nledevil/Racer/hardware/racer/racer.kicad_sch

## KiCad design hardware/racer/racer.kicad_sch (2024-10-18)

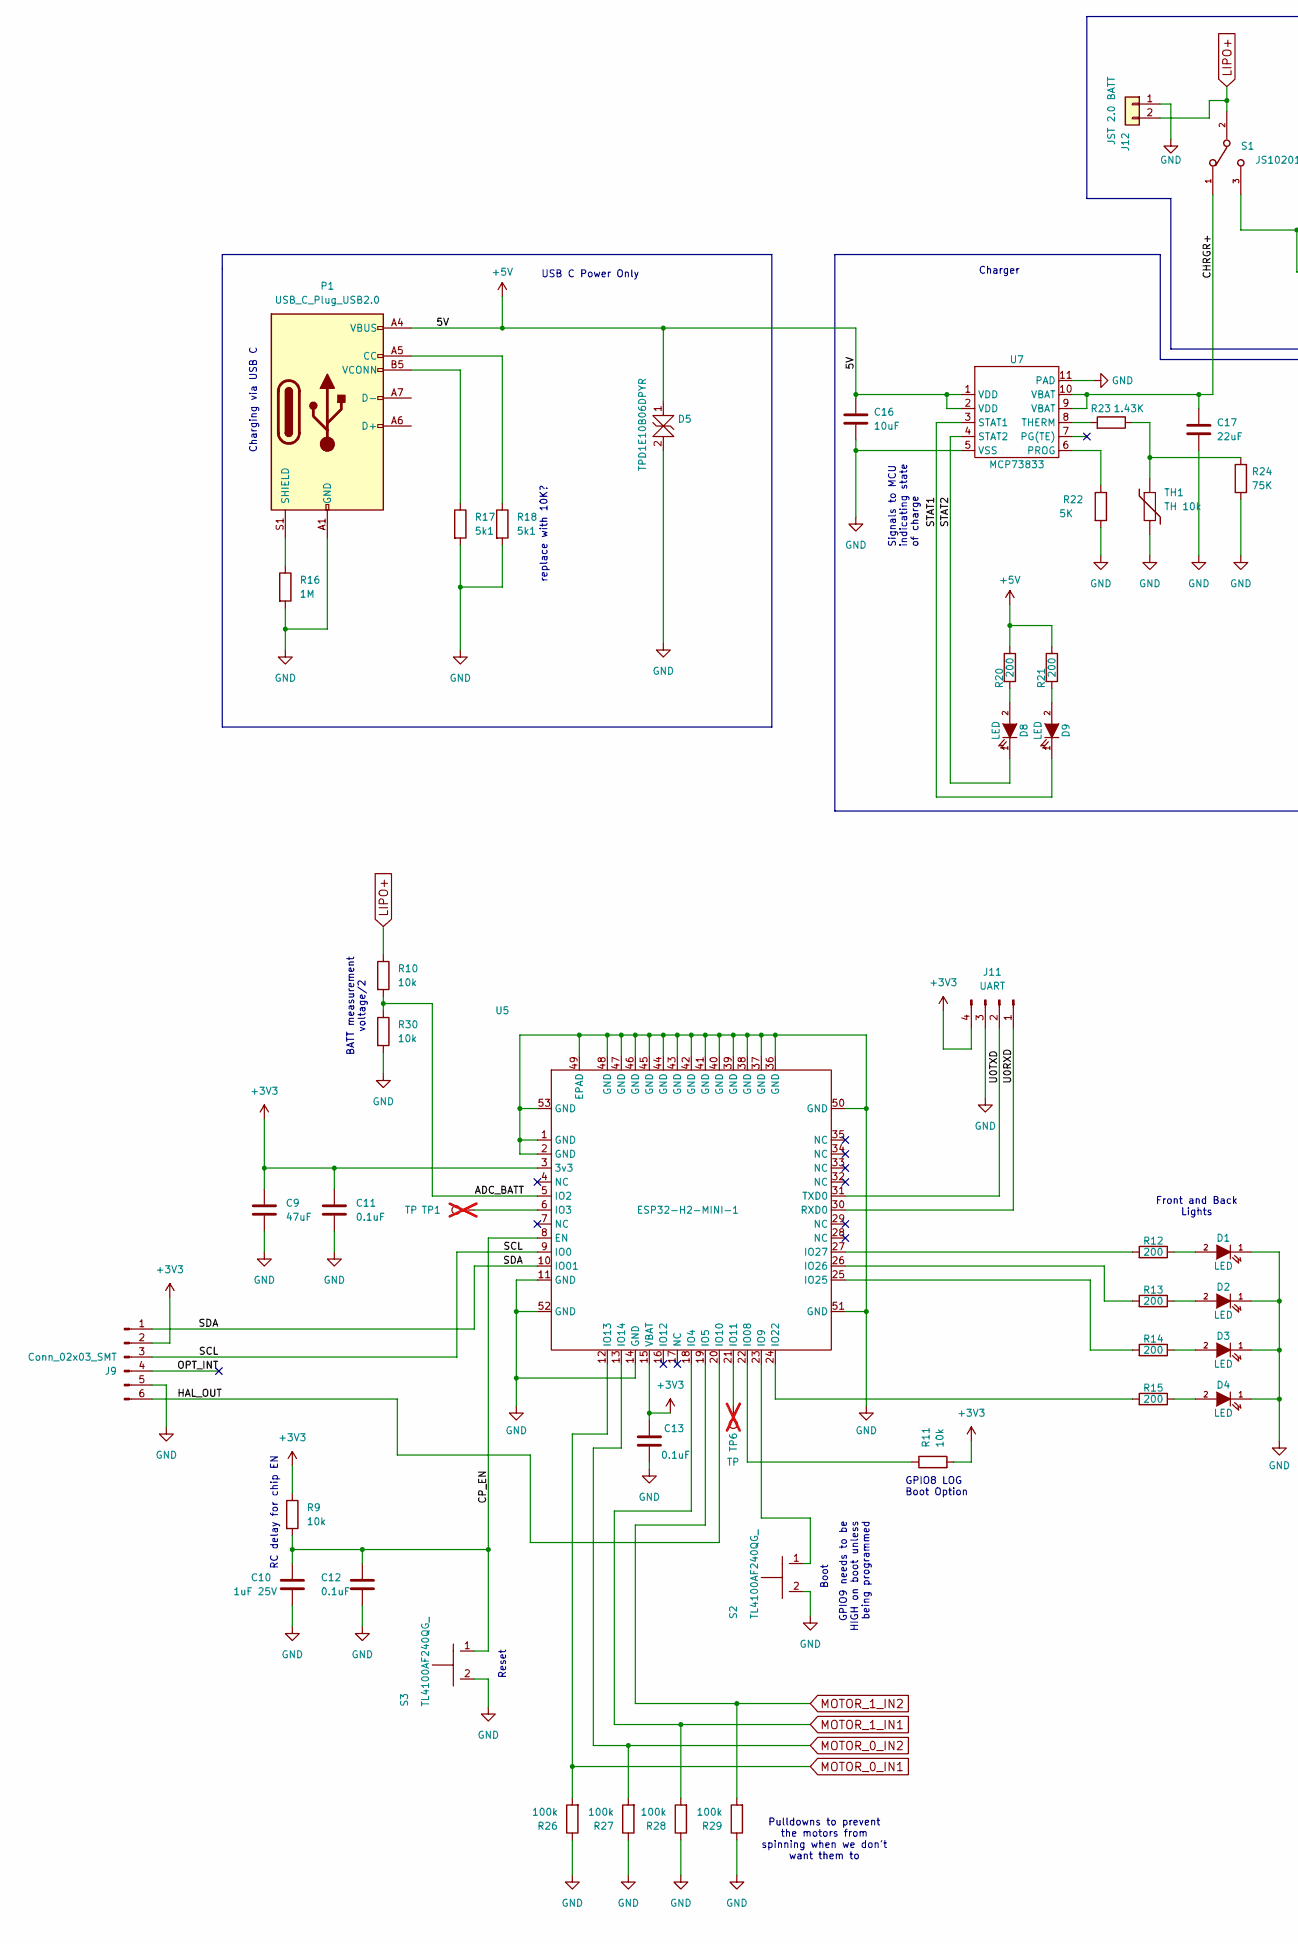
[picture p1: schematic racer.kicad_sch, part in row 1, column 1]

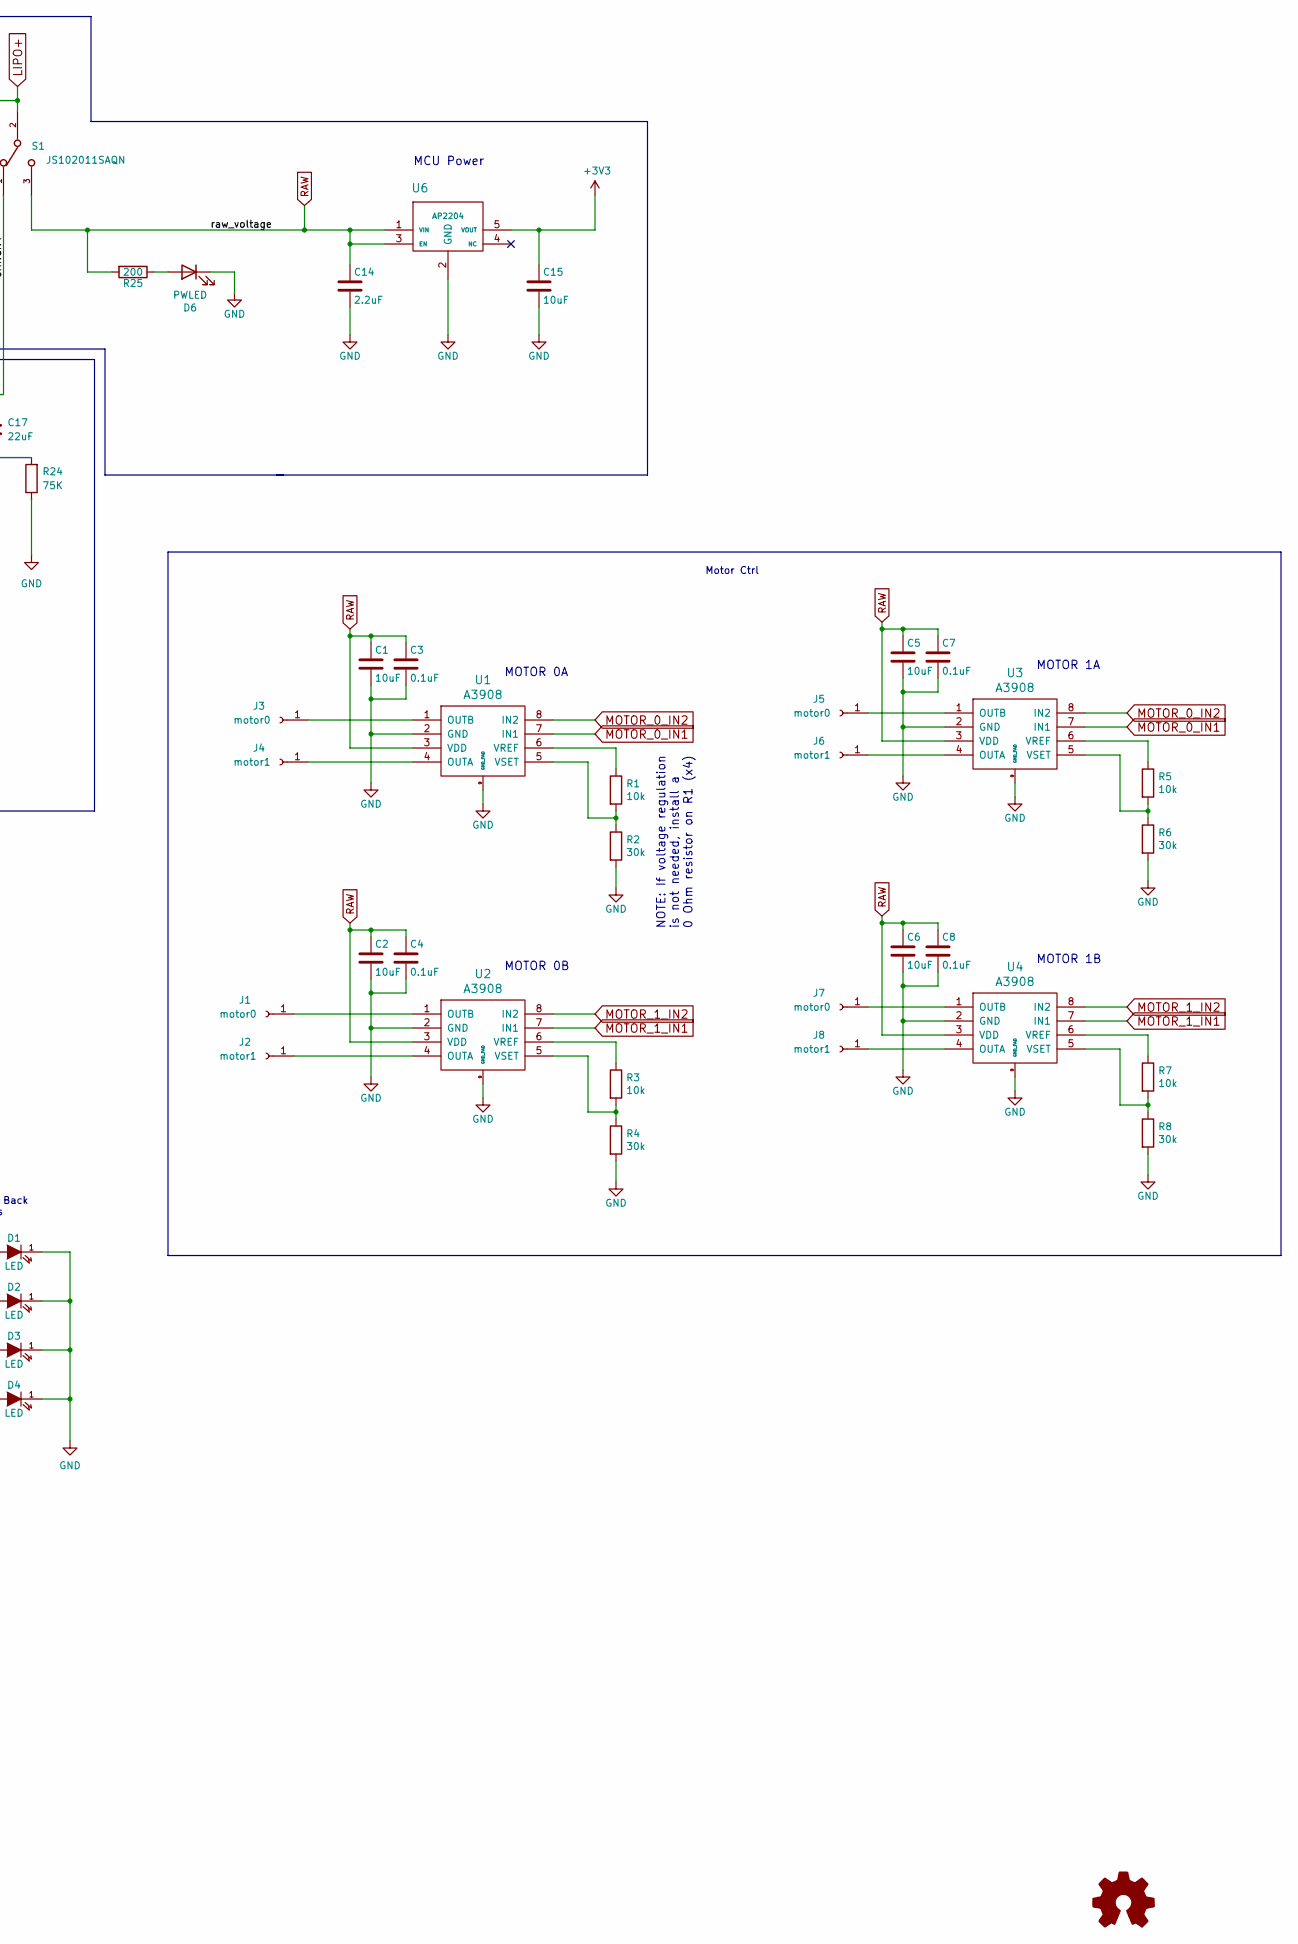
[picture p2: schematic racer.kicad_sch, part in row 1, column 2]

Parts:
C1, C2, C5, C6, C15, C16: 10uF; C_0603_1608Metric; LCSC C19702
C3, C4, C7, C8, C11, C12, C13: 0.1uF; C_0603_1608Metric; LCSC C14663
C9: 47uF; C_0603_1608Metric; LCSC C178330
C10: 1uF 25V; C_0603_1608Metric; LCSC C15849
C14: 2.2uF; C_0603_1608Metric; LCSC C23630
C17: 22uF; C_0603_1608Metric; LCSC C59461
D1, D2, D8, D9: LED; C_0603_1608Metric; LCSC C2286
D3, D4: LED; C_0603_1608Metric; LCSC C2290
D5: TPD1E10B06DPYR; D_SOD-523; LCSC C314264
D6: PWLED; D_0603_1608Metric; LCSC C2286
J1, J3, J5, J7: motor0; TestPoint_Pad_2.0x2.0mm
J2, J4, J6, J8: motor1; TestPoint_Pad_2.0x2.0mm
J9: Conn_02x03_SMT; PinHeader_2x03_P1.27mm_Vertical_SMD
J11: UART; PinHeader_1x04_P2.54mm_Vertical; LCSC C7430360
J12: JST 2.0 BATT; JST_PH_B2B-PH-K_1x02_P2.00mm_Vertical; LCSC C594142
P1: USB_C_Plug_USB2.0; CUI_UJC-VP-3-SMT-TR
R1, R3, R5, R7, R9, R10, R11, R30: 10k; R_0603_1608Metric; LCSC C25804
R2, R4, R6, R8: 30k; R_0603_1608Metric; LCSC C22984
R12, R13, R14, R15, R20, R21, R25: 200; R_0603_1608Metric; LCSC C8218
R16: 1M; R_0603_1608Metric; LCSC C22935
R17, R18: 5k1; R_0603_1608Metric; LCSC C23186
R22: 5K; R_0603_1608Metric
R23: 1.43K; R_0603_1608Metric
R24: 75K; R_0603_1608Metric; LCSC C23242
R26, R27, R28, R29: 100k; R_0603_1608Metric; LCSC C25803
S1: JS102011SAQN; SW_JS102011SAQN
S2, S3: TL4100AF240QG_; SW_PTS810_SJM_250_SMTR_LFS; LCSC C455282
TH1: TH 10k; R_0603_1608Metric; LCSC C13564
TP1, TP6: TP; TestPoint_Pad_D1.0mm; not fitted
U1, U2, U3, U4: A3908
U5: ESP32-H2-MINI-1; MODULE_ESP32-H2-MINI-1-H2; LCSC C18202993
U6: AP2204; LCSC C20627184
U7: MCP73833; SON50P300X300X100-11N; LCSC C627668

Connections:
+3V3: C9.1, C11.1, C13.1, C15.1, J9.2, J11.4, R9.1, R11.2, U5.3 (3v3), U5.15 (VBAT), U6.5 (VOUT)
+5V: C16.1, D5.1, P1.A4 (VBUS), P1.A9 (VBUS), P1.B4 (VBUS), P1.B9 (VBUS), R20.1, R21.1, U7.1 (VDD), U7.2 (VDD)
ADC_BATT: R10.2, R30.1, U5.5 (IO2)
CHRGR+: C17.1, S1.1, U7.9 (VBAT), U7.10 (VBAT)
CP_EN: C10.1, C12.1, R9.2, S3.1, U5.8 (EN)
GND: C1.2, C2.2, C3.2, C4.2, C5.2, C6.2, C7.2, C8.2, C9.2, C10.2, C11.2, C12.2, C13.2, C14.2, C15.2, C16.2, C17.2, D1.1 (K), D2.1 (K), D3.1 (K), D4.1 (K), D5.2, D6.1 (K), J9.5, J11.3, J12.1, P1.A1 (GND), P1.A12 (GND), P1.B1 (GND), P1.B12 (GND), R2.2, R4.2, R6.2, R8.2, R16.2, R17.2, R18.2, R22.2, R24.1, R26.1, R27.1, R28.1, R29.1, R30.2, S2.2, S3.2, TH1.2, U1.2 (GND), U1.9 (GND_PAD), U2.2 (GND), U2.9 (GND_PAD), U3.2 (GND), U3.9 (GND_PAD), U4.2 (GND), U4.9 (GND_PAD), U5.1 (GND), U5.2 (GND), U5.11 (GND), U5.14 (GND), U5.36 (GND), U5.37 (GND), U5.38 (GND), U5.39 (GND), U5.40 (GND), U5.41 (GND), U5.42 (GND), U5.43 (GND), U5.44 (GND), U5.45 (GND), U5.46 (GND), U5.47 (GND), U5.48 (GND), U5.49 (EPAD), U5.50 (GND), U5.51 (GND), U5.52 (GND), U5.53 (GND), U6.2 (GND), U7.5 (VSS), U7.11 (PAD)
HAL_OUT: J9.6, U5.20 (IO10)
LIPO+: J12.2, R10.1, S1.2
MOTOR_0_IN1: R26.2, U1.7 (IN1), U3.7 (IN1), U5.12 (IO13)
MOTOR_0_IN2: R27.2, U1.8 (IN2), U3.8 (IN2), U5.13 (IO14)
MOTOR_1_IN1: R28.2, U2.7 (IN1), U4.7 (IN1), U5.18 (IO4)
MOTOR_1_IN2: R29.2, U2.8 (IN2), U4.8 (IN2), U5.19 (IO5)
unnamed: D1.2 (A), R12.1
unnamed: D2.2 (A), R13.1
unnamed: D3.2 (A), R14.1
unnamed: D4.2 (A), R15.1
unnamed: D6.2 (A), R25.1
unnamed: D8.2 (A), R20.2
unnamed: D9.2 (A), R21.2
unnamed: J1.1, U2.1 (OUTB)
unnamed: J2.1, U2.4 (OUTA)
unnamed: J3.1, U1.1 (OUTB)
unnamed: J4.1, U1.4 (OUTA)
unnamed: J5.1, U3.1 (OUTB)
unnamed: J6.1, U3.4 (OUTA)
unnamed: J7.1, U4.1 (OUTB)
unnamed: J8.1, U4.4 (OUTA)
unnamed: P1.A5 (CC), R18.1
unnamed: P1.B5 (VCONN), R17.1
unnamed: P1.S1 (SHIELD), R16.1
unnamed: R1.1, U1.6 (VREF)
unnamed: R1.2, R2.1, U1.5 (VSET)
unnamed: R3.1, U2.6 (VREF)
unnamed: R3.2, R4.1, U2.5 (VSET)
unnamed: R5.1, U3.6 (VREF)
unnamed: R5.2, R6.1, U3.5 (VSET)
unnamed: R7.1, U4.6 (VREF)
unnamed: R7.2, R8.1, U4.5 (VSET)
unnamed: R11.1, U5.22 (IO08)
unnamed: R12.2, U5.27 (IO27)
unnamed: R13.2, U5.26 (IO26)
unnamed: R14.2, U5.25 (IO25)
unnamed: R15.2, U5.24 (IO22)
unnamed: R22.1, U7.6 (PROG)
unnamed: R23.1, R24.2, TH1.1
unnamed: R23.2, U7.8 (THERM)
unnamed: S2.1, U5.23 (IO9)
unnamed: TP1.1, U5.6 (IO3)
unnamed: TP6.1, U5.21 (IO11)
OPT_INT: J9.4
RAW: C1.1, C2.1, C3.1, C4.1, C5.1, C6.1, C7.1, C8.1, C14.1, R25.2, S1.3, U1.3 (VDD), U2.3 (VDD), U3.3 (VDD), U4.3 (VDD), U6.1 (VIN), U6.3 (EN)
SCL: J9.3, U5.9 (IO0)
SDA: J9.1, U5.10 (IO01)
STAT1: D9.1 (K), U7.3 (STAT1)
STAT2: D8.1 (K), U7.4 (STAT2)
U0RXD: J11.1, U5.30 (RXD0)
U0TXD: J11.2, U5.31 (TXD0)

Notes on the sheet:
MOTOR 1B
Charging via USB C
Signals to MCU indicating state of charge
RC delay for chip EN
Motor Ctrl
replace with 10K?
BATT measurement voltage/2
Front and Back Lights
GPIO8 LOG Boot Option
MOTOR 0A
Reset
GPIO9 needs to be HIGH on boot unless being programmed
Pulldowns to prevent the motors from spinning when we don't want them to
Charger
MCU Power
MOTOR 0B
USB C Power Only
MOTOR 1A
NOTE: If voltage regulation is not needed, install a 0 Ohm resistor on R1 (x4)
Boot
