nledevil/Racer/(commit log)

2024-10-17 fix(lcsc): Starting to add LCSC part numbers
    [racer.kicad_sch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]
2024-10-18 fix(changes): More LCSC numbers added
    [BOM-racer.csv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]
